k-sdm/arena-frame-esp32/device/welcome.jpg

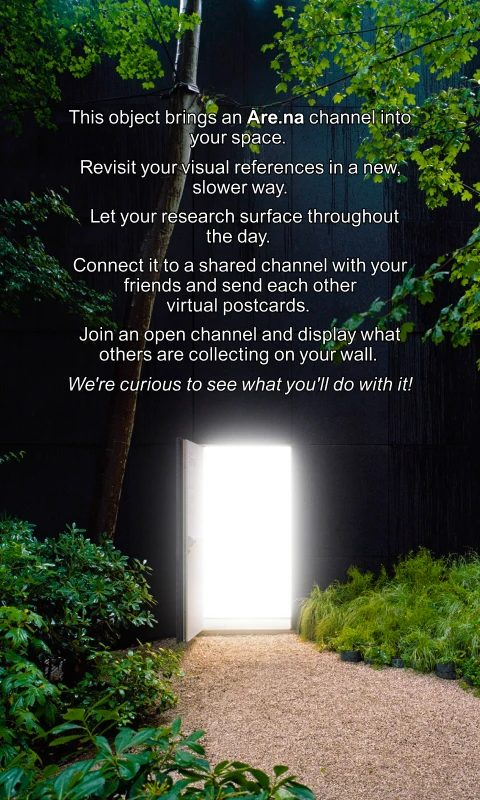
device/welcome.jpg
