k-sdm/arena-frame-esp32/README.md

# Arena Frame on an ESP32-S3

A port of [arena-frame](https://github.com/k-sdm/arena-frame) (Raspberry Pi) to an
ESP32-S3 driving a Pimoroni Inky Impression 7.3" Spectra 6 panel. It connects to WiFi,
pulls blocks from an Are.na channel, fits and dithers images to the panel's six inks,
and draws the block title and channel line beneath.

## Layout

    device/        MicroPython modules that live on the board
      inky.py      panel driver (SPI, full refresh ~29 s)
      image.py     fetch, JPEG decode, scale, Floyd-Steinberg dither, rotate
      render.py    portrait 480x800 canvas, text layout, overlay, rotation
      font.py      1bpp bitmap fonts built from ABC Areal
      arena.py     Are.na API v3 client
      wifi.py      station-mode connection
      main.py      scheduler loop (deployed as frame.py)
      main_boot.py launcher (deployed as main.py, runs on power-up)
      fonts/       generated bitmap fonts
    config-tool/   Web Serial setup page (Chrome/Edge) — configure over USB
    build_font.py  renders a TTF into the bitmap font format
    mpr            mpremote wrapper, finds the board automatically
    flash           esptool wrapper for firmware

## Panels

Chosen in the setup page, stored as `panel` in config.json:

| Setting | Panel | Pixels | Controller | State |
|---|---|---|---|---|
| `7.3` | Inky Impression 7.3" | 800 x 480 | EL673 | tested |
| `4.0` | Inky Impression 4" | 600 x 400 | E640 | same command set, untested |
| `13.3` | Inky Impression 13.3" | 1600 x 1200 | EL133UF1 | untested, needs a second chip-select |

The 4" differs from the 7.3" only in the resolution bytes and one pre-refresh value.
The 13.3" is a different controller: two of them, each driving 600 of the 1200 columns,
at 10 MHz with a refresh around 65 s. It needs a second CS line (Pi header pins 37 and
36, BCM 26 and 16) — the carrier board wires one CS, so that panel needs a board revision.
A later revision is to read the panel's EEPROM and pick the size itself.

## Wiring

| Inky header pin | Signal | ESP32-S3 |
|---|---|---|
| 19 | MOSI | GPIO 11 |
| 23 | SCLK | GPIO 12 |
| 24 | Chip select | GPIO 10 |
| 15 | Data/command | GPIO 9 |
| 13 | Reset | GPIO 8 |
| 11 | Busy | GPIO 7 |
| 2 / 1 / 6 | 5V / 3V3 / GND | 5V / 3V3 / GND |

MISO is unused. Avoid GPIO 26-37 (flash and octal PSRAM), 0/3/45/46 (strapping),
19/20 (USB), 43/44 (UART) and 38 (RGB LED).

## Provisioning a fresh board

    ./provision              # firmware, code, fonts, boot launcher
    ./provision --code-only  # push code changes, keeping settings

It fetches the tools and firmware on first run, erases and flashes the chip, copies
everything across and checks what landed. Then set WiFi and the channel from
`config-tool/index.html`. Pass `PORT=/dev/cu.usbmodem...` to choose a board.

## Firmware

MicroPython with a JPEG decoder: the prebuilt
[mp_jpeg](https://github.com/cnadler86/mp_jpeg) build for `ESP32_GENERIC_S3-SPIRAM_OCT`.
Flash it over the board's UART port (the native USB port will not enter download mode):

    ./flash firmware/firmware.bin

## Deploying the code

    ./mpr fs cp device/*.py :
    ./mpr fs cp device/main.py :frame.py
    ./mpr fs cp device/main_boot.py :main.py
    ./mpr fs mkdir fonts && ./mpr fs cp device/fonts/*.bin :fonts/

Then open `config-tool/index.html` in Chrome (over https or localhost) to set WiFi,
the channel and display options. Settings live in `config.json` on the board; position
in the channel is kept in `state.json`.

## Notes on the panel

This is the 2026 "AC waveform" Spectra 6 panel (EEPROM variant 26). A full refresh takes
about 29 s. Partial refresh via the 0x83 window register does not confine the waveform on
this revision — the whole panel cycles — so the frame uses full refreshes only.
