k-sdm/arena-frame-esp32/inky-esp32-carrier/inky-esp32-carrier.kicad_pcb

## KiCad design inky-esp32-carrier/inky-esp32-carrier.kicad_pcb (2026-10-12)

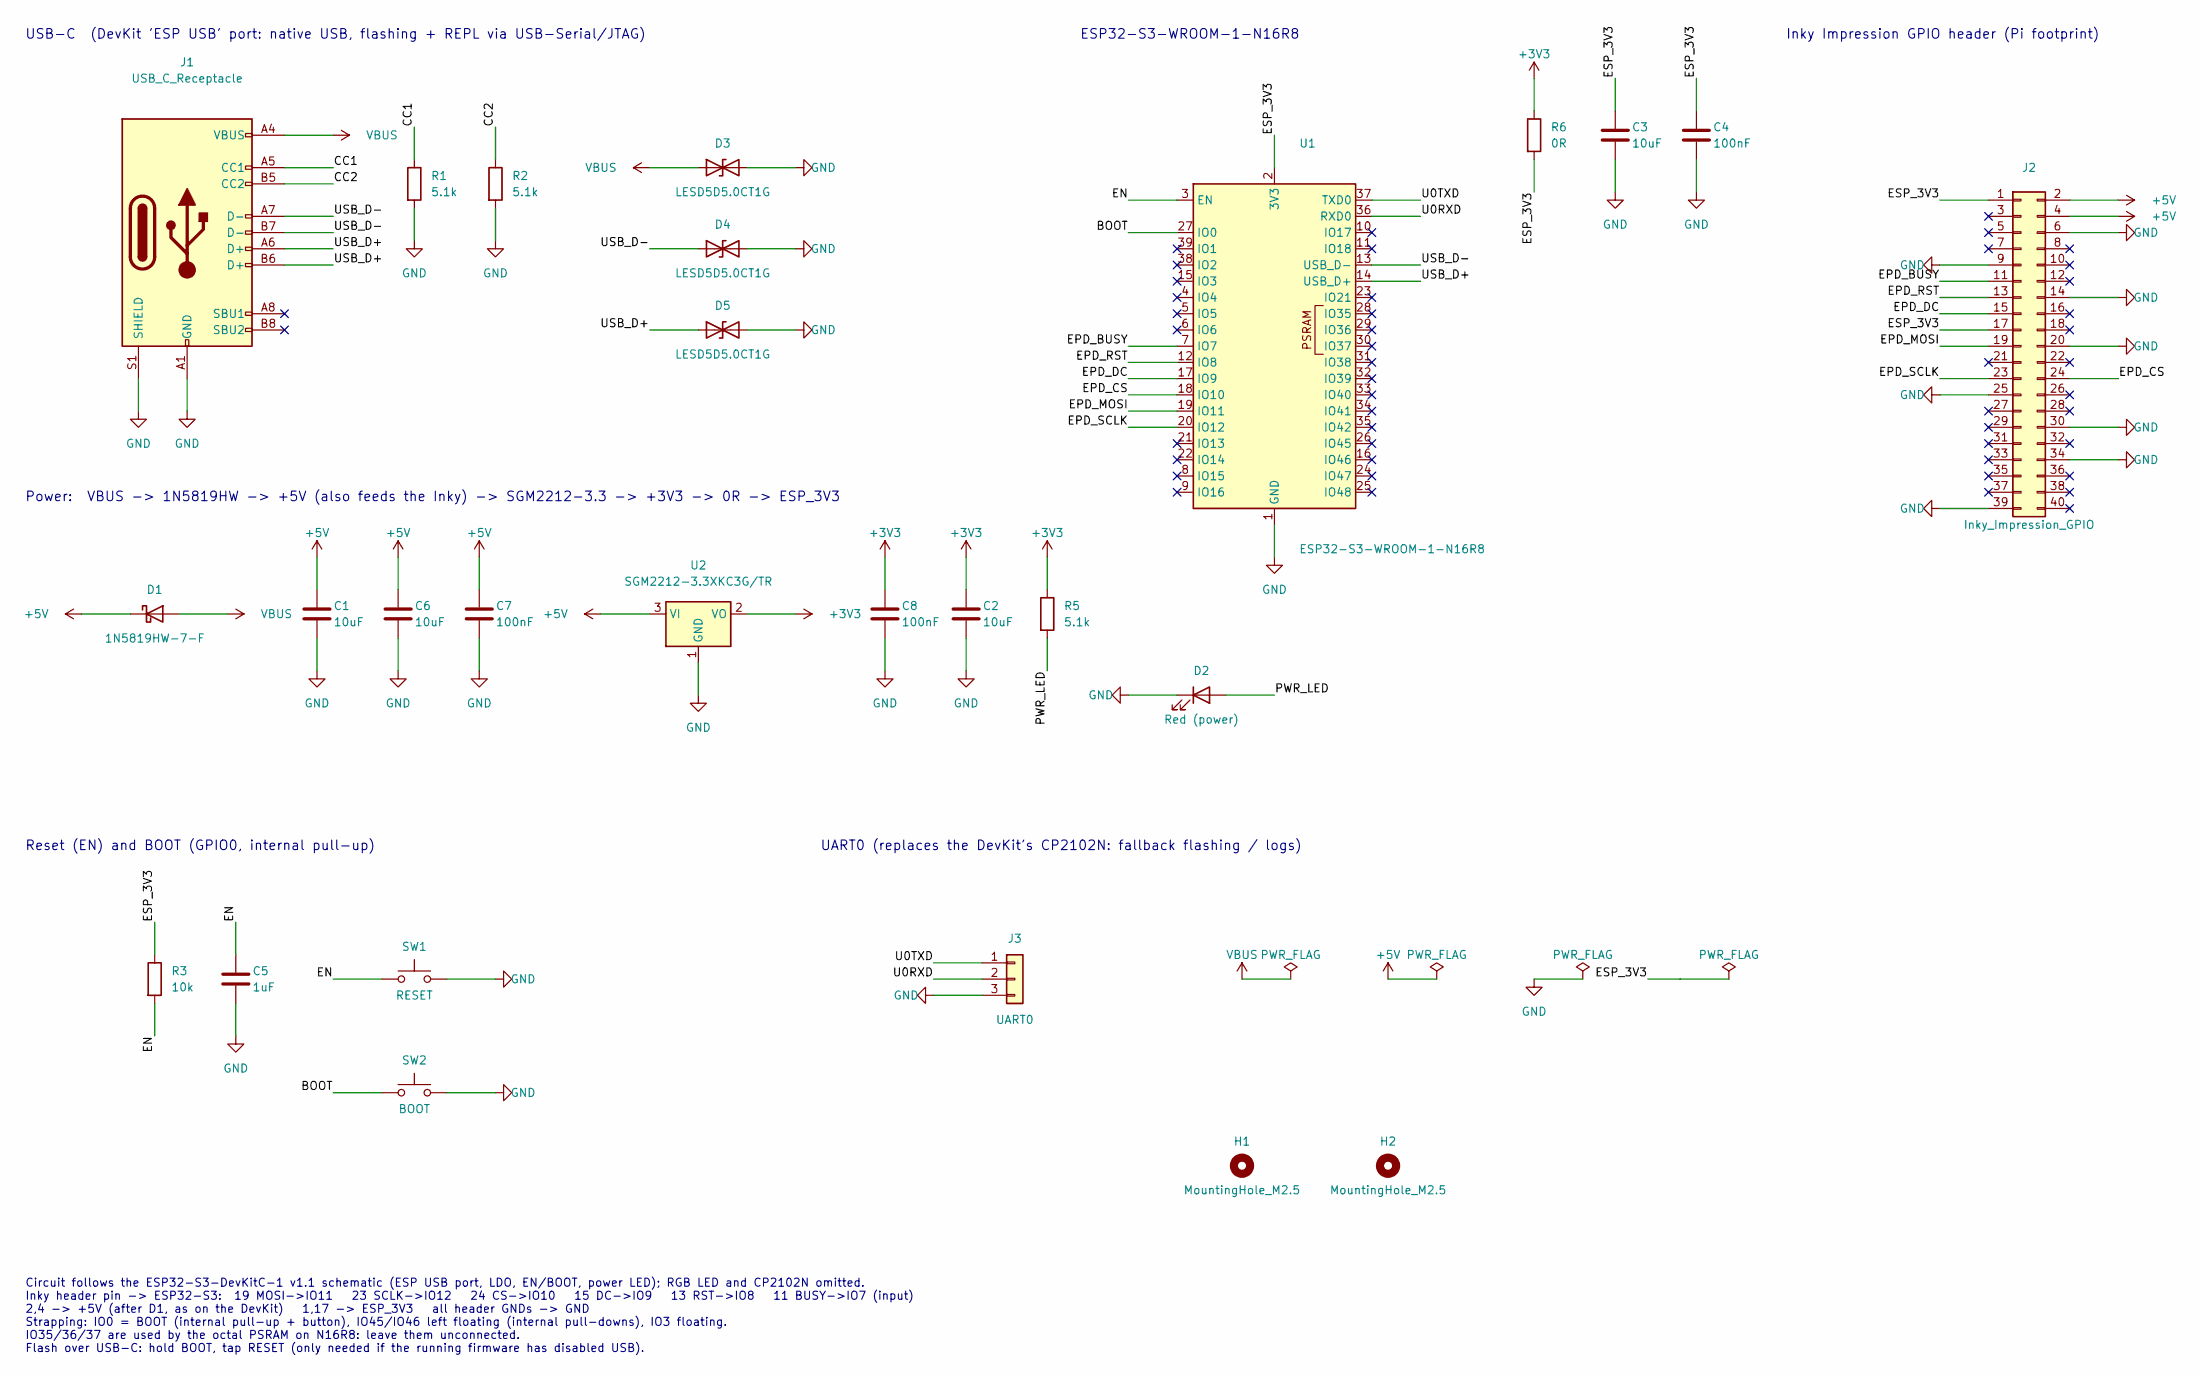
[picture p2: schematic inky-esp32-carrier.kicad_sch, Inky Impression ESP32-S3 carrier]

Parts:
C1, C2, C3, C6: 10uF; C_0805_2012Metric
C4, C7, C8: 100nF; C_0603_1608Metric
C5: 1uF; C_0603_1608Metric
D1: 1N5819HW-7-F; D_SOD-123
D2: Red (power); LED_0603_1608Metric
D3, D4, D5: LESD5D5.0CT1G; D_SOD-523
H1, H2: MountingHole_M2.5; MountingHole_2.7mm_M2.5
J1: USB_C_Receptacle; USB_C_Receptacle_HRO_TYPE-C-31-M-12
J2: Inky_Impression_GPIO; PinHeader_2x20_P2.54mm_Vertical
J3: UART0; PinHeader_1x03_P2.54mm_Vertical
R1, R2, R5: 5.1k; R_0603_1608Metric
R3: 10k; R_0603_1608Metric
R6: 0R; R_0603_1608Metric
SW1: RESET; SW_Push_1P1T_XKB_TS-1187A
SW2: BOOT; SW_Push_1P1T_XKB_TS-1187A
U1: ESP32-S3-WROOM-1-N16R8; ESP32-S3-WROOM-1_BodyCourtyard
U2: SGM2212-3.3XKC3G/TR; SOT-223-3_TabPin2

Connections:
+3V3: C2.1, C8.1, R5.1, R6.1, U2.2 (VO)
+5V: C1.1, C6.1, C7.1, D1.1 (K), J2.2, J2.4, U2.3 (VI)
/BOOT: SW2.1, U1.27 (IO0)
/CC1: J1.A5 (CC1), R1.1
/CC2: J1.B5 (CC2), R2.1
/EN: C5.1, R3.2, SW1.1, U1.3 (EN)
/EPD_BUSY: J2.11, U1.7 (IO7)
/EPD_CS: J2.24, U1.18 (IO10)
/EPD_DC: J2.15, U1.17 (IO9)
/EPD_MOSI: J2.19, U1.19 (IO11)
/EPD_RST: J2.13, U1.12 (IO8)
/EPD_SCLK: J2.23, U1.20 (IO12)
/ESP_3V3: C3.1, C4.1, J2.1, J2.17, R3.1, R6.2, U1.2 (3V3)
/PWR_LED: D2.2 (A), R5.2
/U0RXD: J3.2, U1.36 (RXD0)
/U0TXD: J3.1, U1.37 (TXD0)
/USB_D+: D5.1 (A1), J1.A6 (D+), J1.B6 (D+), U1.14 (USB_D+)
/USB_D-: D4.1 (A1), J1.A7 (D-), J1.B7 (D-), U1.13 (USB_D-)
GND: C1.2, C2.2, C3.2, C4.2, C5.2, C6.2, C7.2, C8.2, D2.1 (K), D3.2 (A2), D4.2 (A2), D5.2 (A2), J1.A1 (GND), J1.A12 (GND), J1.B1 (GND), J1.B12 (GND), J1.S1 (SHIELD), J2.6, J2.9, J2.14, J2.20, J2.25, J2.30, J2.34, J2.39, J3.3, R1.2, R2.2, SW1.2, SW2.2, U1.1 (GND), U1.40 (GND), U1.41 (GND), U2.1 (GND)
VBUS: D1.2 (A), D3.1 (A1), J1.A4 (VBUS), J1.A9 (VBUS), J1.B4 (VBUS), J1.B9 (VBUS)

Notes on the sheet:
USB-C (DevKit 'ESP USB' port: native USB, flashing + REPL via USB-Serial/JTAG)
Power: VBUS -> 1N5819HW -> +5V (also feeds the Inky) -> SGM2212-3.3 -> +3V3 -> 0R -> ESP_3V3
ESP32-S3-WROOM-1-N16R8
Reset (EN) and BOOT (GPIO0, internal pull-up)
UART0 (replaces the DevKit's CP2102N: fallback flashing / logs)
Inky Impression GPIO header (Pi footprint)
Circuit follows the ESP32-S3-DevKitC-1 v1.1 schematic (ESP USB port, LDO, EN/BOOT, power LED); RGB LED and CP2102N omitted. Inky header pin -> ESP32-S3: 19 MOSI->IO11 23 SCLK->IO12 24 CS->IO10 15 DC->IO9 13 RST->IO8 11 BUSY->IO7 (input) 2,4 -> +5V (after D1, as on the DevKit) 1,17 -> ESP_3V3 all he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

Board: 2 copper layers, 27 parts (1 on the bottom side), 20 nets, no tracks yet.
