k-sdm/arena-frame-esp32/(commit log)

2026-10-12 Arena Frame port to ESP32-S3 with Inky Impression 7.3"
    MicroPython frame: WiFi, Are.na API v3, JPEG decode, Floyd-Steinberg dithering
    to the panel's six inks, portrait canvas with title and channel overlay, dark
    mode, and position tracking through the channel. Includes a Web Serial setup
    page for configuring the board over USB from Chrome.
    [inky-esp32-carrier.kicad_pcb, inky-esp32-carrier.kicad_sch]
2026-10-12 Setup page: keep blank fields from wiping stored settings
    The password and token are never read back into the page, so saving with those
    fields blank overwrote them with empty strings. They are now omitted when blank
    and the save merges into the config already on the board. Dark mode also
    defaulted to on for configs that predate the toggle; it now defaults off.
2026-10-12 Setup page: restart the frame after saving or drawing
    Taking the serial port stops the frame's loop, so saving settings or drawing a
    block left the frame idle until someone reset it by hand. Both now reset the
    board when they finish.
    [inky-esp32-carrier.kicad_pcb, inky-esp32-carrier.kicad_sch]
2026-10-12 Setup page: restart the frame after saving or drawing
    board when they finish. Also ignore KiCad lock files.
    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
2026-10-20 Setup page: say it needs Chrome or Edge, and which device to pick
    Web Serial exists only in Chrome and Edge, and the browser's device list names
    the board by its USB chip rather than anything recognisable.
2026-10-20 Add a provisioning script for fresh boards
    One command to take a bare ESP32-S3 to a working frame: fetch the tools and
    firmware if missing, erase and flash, deploy the modules, fonts and boot
    launcher, then verify what landed. --code-only redeploys without erasing.
2026-10-20 Finish provisioning by drawing the welcome card
    A fresh board now ends its setup by decoding and dithering welcome.jpg to the
    panel, which proves the decoder, the dithering and the display wiring in one
    step. image.render_file() renders a JPEG already on the board.
2026-10-21 Support the 4" and 13.3" panels, chosen in the setup page
    Panel size is now a setting rather than constants baked into the code: the
    renderer, the dithering pass and the rotation all take their dimensions from the
    selected panel. The 4" shares the 7.3"'s command set, differing only in the
    resolution bytes and one pre-refresh value. The 13.3" is a separate driver: two
    controllers each take half the panel, which also needs a second chip-select the
    current board does not have. Both are untested for want of the hardware.
